maximedaniel/CairnFORM/img/case.png

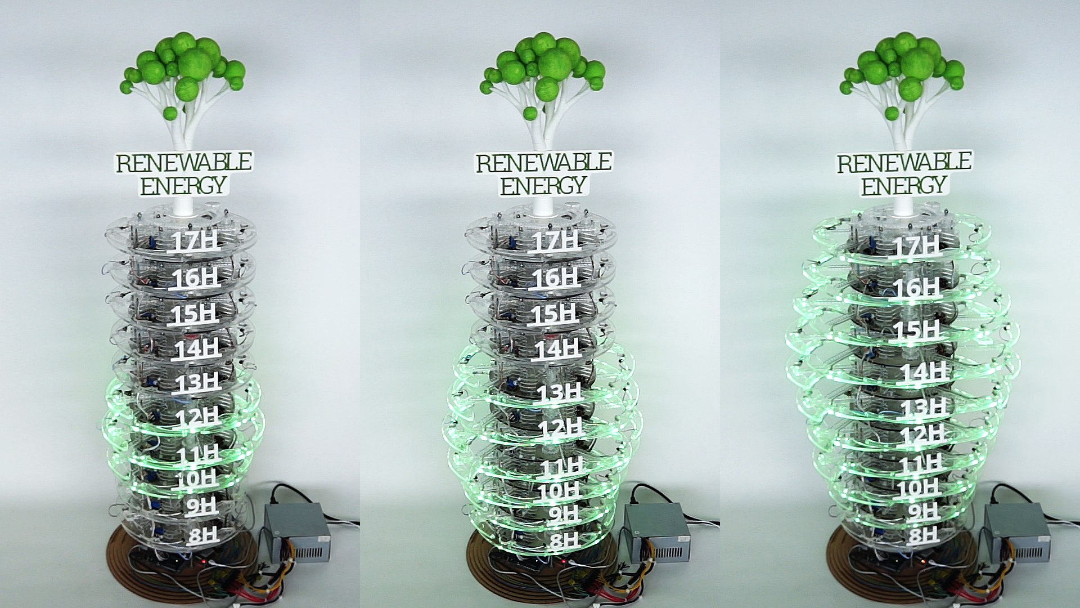
img/case.png
