maximedaniel/CairnFORM/img/tech0.png

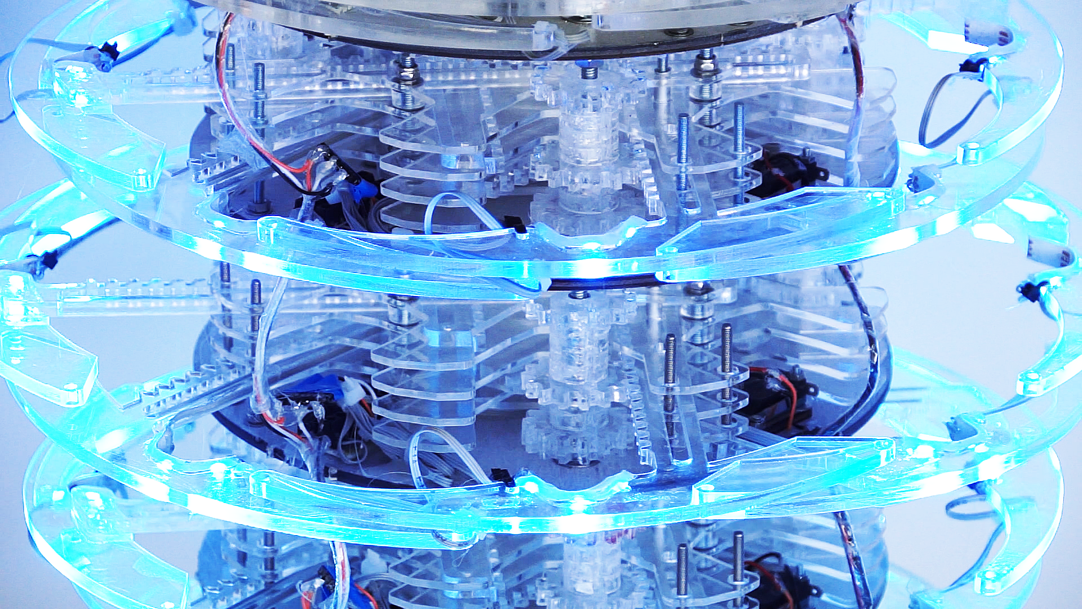
img/tech0.png
