maximedaniel/CairnFORM/img/tech1.png

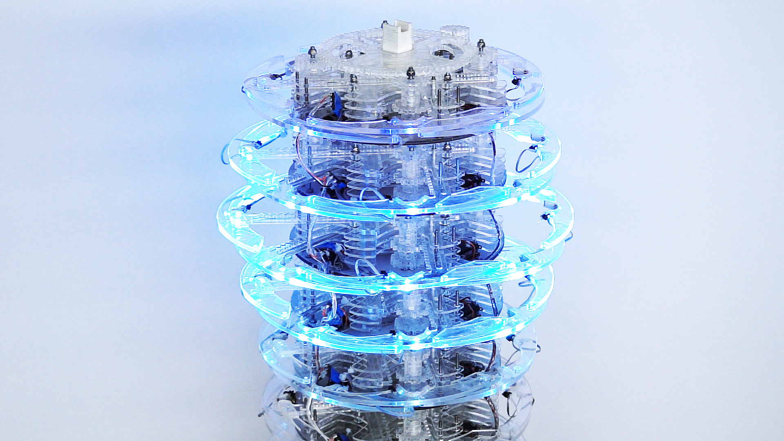
img/tech1.png
