maximedaniel/CairnFORM/img/tech2.png

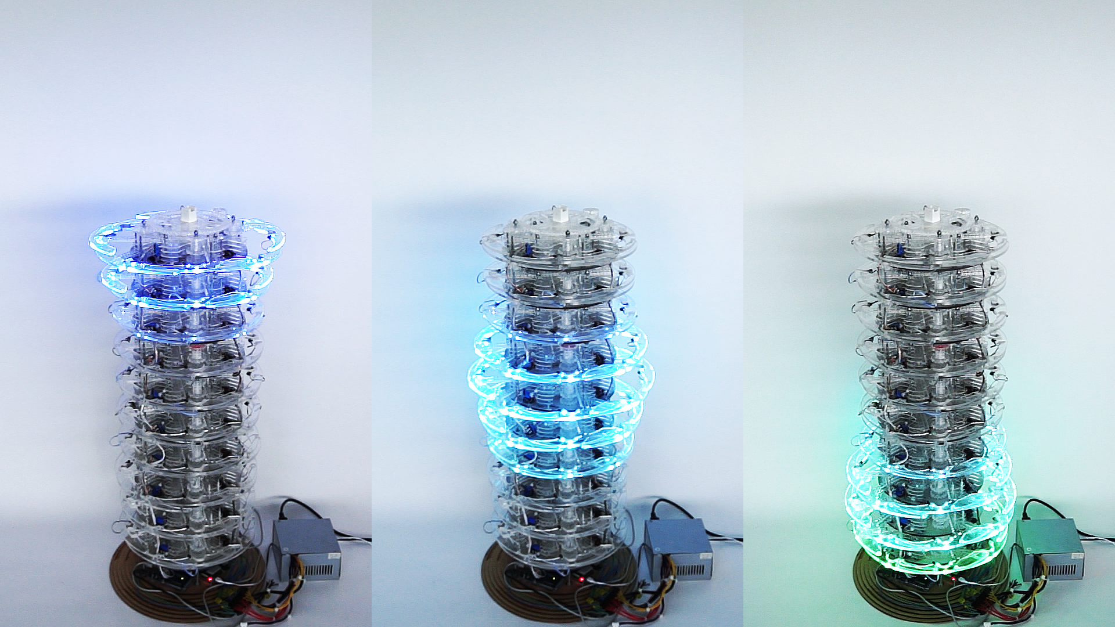
img/tech2.png
