maximedaniel/CairnFORM/driver/Arduino_Mega/Arduino_Mega.ino

#include <Adafruit_NeoPixel.h>
#include <stdio.h>
#include <stdlib.h>
#ifdef __AVR__
  #include <avr/power.h>
#endif

#define NUMPIXELS        12
#define PWM_SIZE         12
#define PWM_0            13
#define PWM_1            12
#define PWM_2            11
#define PWM_3            10
#define PWM_4            9
#define PWM_5            8
#define PWM_6            7
#define PWM_7            6
#define PWM_8            5
#define PWM_9            4
#define PWM_10           3
#define PWM_11           2


// Parameter 1 = number of pixels in strip
// Parameter 2 = Arduino pin number (most are valid)
// Parameter 3 = pixel type flags, add together as needed:
//   NEO_KHZ800  800 KHz bitstream (most NeoPixel products w/WS2812 LEDs)
//   NEO_KHZ400  400 KHz (classic 'v1' (not v2) FLORA pixels, WS2811 drivers)
//   NEO_GRB     Pixels are wired for GRB bitstream (most NeoPixel products)
//   NEO_RGB     Pixels are wired for RGB bitstream (v1 FLORA pixels, not v2)
//   NEO_RGBW    Pixels are wired for RGBW bitstream (NeoPixel RGBW products)

Adafruit_NeoPixel pixels [PWM_SIZE] = {
    Adafruit_NeoPixel(NUMPIXELS, PWM_0, NEO_GRB + NEO_KHZ800),
    Adafruit_NeoPixel(NUMPIXELS, PWM_1, NEO_GRB + NEO_KHZ800),
    Adafruit_NeoPixel(NUMPIXELS, PWM_2, NEO_GRB + NEO_KHZ800),
    Adafruit_NeoPixel(NUMPIXELS, PWM_3, NEO_GRB + NEO_KHZ800),
    Adafruit_NeoPixel(NUMPIXELS, PWM_4, NEO_GRB + NEO_KHZ800),
    Adafruit_NeoPixel(NUMPIXELS, PWM_5, NEO_GRB + NEO_KHZ800),
    Adafruit_NeoPixel(NUMPIXELS, PWM_6, NEO_GRB + NEO_KHZ800),
    Adafruit_NeoPixel(NUMPIXELS, PWM_7, NEO_GRB + NEO_KHZ800),
    Adafruit_NeoPixel(NUMPIXELS, PWM_8, NEO_GRB + NEO_KHZ800),
    Adafruit_NeoPixel(NUMPIXELS, PWM_9, NEO_GRB + NEO_KHZ800),
    Adafruit_NeoPixel(NUMPIXELS, PWM_10, NEO_GRB + NEO_KHZ800),
    Adafruit_NeoPixel(NUMPIXELS, PWM_11, NEO_GRB + NEO_KHZ800)
};

int SIZE_PACKAGE = 4;

// IMPORTANT: To reduce NeoPixel burnout risk, add 1000 uF capacitor across
// pixel power leads, add 300 - 500 Ohm resistor on first pixel's data input
// and minimize distance between Arduino and first pixel.  Avoid connecting
// on a live circuit...if you must, connect GND first.



int delayval = 500; // delay for half a second

void setup() {
  // This is for Trinket 5V 16MHz, you can remove these three lines if you are not using a Trinket
  Serial.begin(9600);
#if defined (__AVR_ATtiny85__)
  if (F_CPU == 16000000) clock_prescale_set(clock_div_1);
#endif
  // End of trinket special code

  for(int j=0;j<PWM_SIZE;j++){
      pixels[j].begin(); // This initializes the NeoPixel library.
  }
}

void loop() { 
  // Read serial input:
   char package[SIZE_PACKAGE];
  while (Serial.available() > SIZE_PACKAGE - 1) {
    Serial.readBytes(package, SIZE_PACKAGE);
    if(package[0] >= 0 && package[0]<PWM_SIZE){
      for(int i = 0; i < NUMPIXELS; i++){
        pixels[package[0]].setPixelColor(i, pixels[package[0]].Color(package[1], package[2], package[3]));
      }
      pixels[package[0]].show(); 
    }
  }
}
