maximedaniel/CairnFORM/driver/Transition.py

import math

# Define motion transition modes
class Transition:
    LINEAR = 'LINEAR'
    EASE_IN_QUAD = 'EASE_IN_QUAD'
    EASE_OUT_QUAD = 'EASE_OUT_QUAD'
    EASE_IN_OUT_QUAD = 'EASE_IN_OUT_QUAD'

    EASE_IN_CUBIC = 'EASE_IN_CUBIC'
    EASE_OUT_CUBIC = 'EASE_OUT_CUBIC'
    EASE_IN_OUT_CUBIC = 'EASE_IN_OUT_CUBIC'

    EASE_IN_QUART = 'EASE_IN_QUART'
    EASE_OUT_QUART = 'EASE_OUT_QUART'
    EASE_IN_OUT_QUART = 'EASE_IN_OUT_QUART'

    EASE_IN_QUINT = 'EASE_IN_QUINT'
    EASE_OUT_QUINT = 'EASE_OUT_QUINT'
    EASE_IN_OUT_QUINT = 'EASE_IN_OUT_QUINT'

    EASE_IN_SINE = 'EASE_IN_SINE'
    EASE_OUT_SINE = 'EASE_OUT_SINE'
    EASE_IN_OUT_SINE = 'EASE_IN_OUT_SINE'

    EASE_IN_EXPO = 'EASE_IN_EXPO'
    EASE_OUT_EXPO = 'EASE_OUT_EXPO'
    EASE_IN_OUT_EXPO = 'EASE_IN_OUT_EXPO'

    EASE_IN_CIRC = 'EASE_IN_CIRC'
    EASE_OUT_CIRC = 'EASE_OUT_CIRC'
    EASE_IN_OUT_CIRC = 'EASE_IN_OUT_CIRC'

    # simple linear tweening - no easing, no acceleration
    @classmethod
    def linearTween(cls, t, b, c, d):
        return c * t / d + b

    # quadratic easing in - accelerating from zero velocity

    @classmethod
    def easeInQuad(cls, t, b, c, d):
        t /= d
        return c * t * t + b

    # quadratic easing out - decelerating to zero velocity

    @classmethod
    def easeOutQuad(cls, t, b, c, d):
        t /= d
        return -c * t * (t - 2) + b

    # quadratic easing in/out - acceleration until halfway, then deceleration

    @classmethod
    def easeInOutQuad(cls, t, b, c, d):
        t /= d / 2
        if t < 1:
            return c / 2 * t * t + b
        t -= 1
        return -c / 2 * (t * (t - 2) - 1) + b

    # cubic easing in - accelerating from zero velocity

    @classmethod
    def easeInCubic(cls, t, b, c, d):
        t /= d
        return c * t * t * t + b

    # cubic easing out - decelerating to zero velocity

    @classmethod
    def easeOutCubic(cls, t, b, c, d):
        t /= d
        t -= 1
        return c * (t * t * t + 1) + b

    # cubic easing in/out - acceleration until halfway, then deceleration

    @classmethod
    def easeInOutCubic(cls, t, b, c, d):
        t /= d / 2
        if t < 1:
            return c / 2 * t * t * t + b
        t -= 2
        return c / 2 * (t * t * t + 2) + b

    # quartic easing in - accelerating from zero velocity

    @classmethod
    def easeInQuart(cls, t, b, c, d):
        t /= d
        return c * t * t * t * t + b

    # quartic easing out - decelerating to zero velocity

    @classmethod
    def easeOutQuart(cls, t, b, c, d):
        t /= d
        t -= 1
        return -c * (t * t * t * t - 1) + b

    # quartic easing in/out - acceleration until halfway, then deceleration

    @classmethod
    def easeInOutQuart(cls, t, b, c, d):
        t /= d / 2
        if t < 1:
            return c / 2 * t * t * t * t + b
        t -= 2
        return -c / 2 * (t * t * t * t - 2) + b

    # quintic easing in - accelerating from zero velocity

    @classmethod
    def easeInQuint(cls, t, b, c, d):
        t /= d
        return c * t * t * t * t * t + b

    # quintic easing out - decelerating to zero velocity

    @classmethod
    def easeOutQuint(cls, t, b, c, d):
        t /= d
        t -= 1
        return c * (t * t * t * t * t + 1) + b

    # quintic easing in/out - acceleration until halfway, then deceleration

    @classmethod
    def easeInOutQuint(cls, t, b, c, d):
        t /= d / 2
        if t < 1:
            return c / 2 * t * t * t * t * t + b
        t -= 2
        return c / 2 * (t * t * t * t * t + 2) + b

    # sinusoidal easing in - accelerating from zero velocity

    @classmethod
    def easeInSine(cls, t, b, c, d):
        return -c * math.cos(t / d * (math.pi / 2)) + c + b

    # sinusoidal easing out - decelerating to zero velocity

    @classmethod
    def easeOutSine(cls, t, b, c, d):
        return c * math.sin(t / d * (math.pi / 2)) + b

    # sinusoidal easing in/out - accelerating until halfway, then decelerating

    @classmethod
    def easeInOutSine(cls, t, b, c, d):
        return -c / 2 * (math.cos(math.pi * t / d) - 1) + b

    # exponential easing in - accelerating from zero velocity

    @classmethod
    def easeInExpo(cls, t, b, c, d):
        return c * math.pow(2, 10 * (t / d - 1)) + b

    # exponential easing out - decelerating to zero velocity

    @classmethod
    def easeOutExpo(cls, t, b, c, d):
        return c * (-math.pow(2, -10 * t / d) + 1) + b

    # exponential easing in/out - accelerating until halfway, then decelerating

    @classmethod
    def easeInOutExpo(cls, t, b, c, d):
        t /= d / 2
        if t < 1:
            return c / 2 * math.pow(2, 10 * (t - 1)) + b
        t -= 1
        return c / 2 * (-math.pow(2, -10 * t) + 2) + b

    # circular easing in - accelerating from zero velocity

    @classmethod
    def easeInCirc(cls, t, b, c, d):
        t /= d
        return -c * (math.sqrt(1 - t * t) - 1) + b

    # circular easing out - decelerating to zero velocity

    @classmethod
    def easeOutCirc(cls, t, b, c, d):
        t /= d
        t -= 1
        return c * math.sqrt(1 - t * t) + b

    # circular easing in/out - acceleration until halfway, then deceleration

    @classmethod
    def easeInOutCirc(cls, t, b, c, d):
        t /= d / 2
        if t < 1:
            return -c / 2 * (math.sqrt(1 - t * t) - 1) + b
        t -= 2
        return c / 2 * (math.sqrt(1 - t * t) + 1) + b

    @classmethod
    def transition(cls, mode, t, b, c, d):
        if mode == cls.LINEAR:
            return cls.linearTween(t, b, c, d)

        if mode == cls.EASE_IN_QUAD:
            return cls.easeInQuad(t, b, c, d)

        if mode == cls.EASE_OUT_QUAD:
            return cls.easeOutQuad(t, b, c, d)

        if mode == cls.EASE_IN_OUT_QUAD:
            return cls.easeInOutQuad(t, b, c, d)

        if mode == cls.EASE_IN_CUBIC:
            return cls.easeInCubic(t, b, c, d)

        if mode == cls.EASE_OUT_CUBIC:
            return cls.easeOutCubic(t, b, c, d)

        if mode == cls.EASE_IN_OUT_CUBIC:
            return cls.easeInOutCubic(t, b, c, d)

        if mode == cls.EASE_IN_QUART:
            return cls.easeInQuart(t, b, c, d)

        if mode == cls.EASE_OUT_QUART:
            return cls.easeOutQuart(t, b, c, d)

        if mode == cls.EASE_IN_OUT_QUART:
            return cls.easeInOutQuart(t, b, c, d)

        if mode == cls.EASE_IN_QUINT:
            return cls.easeInQuint(t, b, c, d)

        if mode == cls.EASE_OUT_QUINT:
            return cls.easeOutQuint(t, b, c, d)

        if mode == cls.EASE_IN_OUT_QUINT:
            return cls.easeInOutQuint(t, b, c, d)

        if mode == cls.EASE_IN_SINE:
            return cls.easeInSine(t, b, c, d)

        if mode == cls.EASE_OUT_SINE:
            return cls.easeOutSine(t, b, c, d)

        if mode == cls.EASE_IN_OUT_SINE:
            return cls.easeInOutSine(t, b, c, d)

        if mode == cls.EASE_IN_EXPO:
            return cls.easeInExpo(t, b, c, d)

        if mode == cls.EASE_OUT_EXPO:
            return cls.easeOutExpo(t, b, c, d)

        if mode == cls.EASE_IN_OUT_EXPO:
            return cls.easeInOutExpo(t, b, c, d)

        if mode == cls.EASE_IN_CIRC:
            return cls.easeInCirc(t, b, c, d)

        if mode == cls.EASE_OUT_CIRC:
            return cls.easeOutCirc(t, b, c, d)

        if mode == cls.EASE_IN_OUT_CIRC:
            return cls.easeInOutCirc(t, b, c, d)

    @classmethod
    def isMode(cls, mode):
        if mode == cls.LINEAR:
            return True

        if mode == cls.EASE_IN_QUAD:
            return True

        if mode == cls.EASE_OUT_QUAD:
            return True

        if mode == cls.EASE_IN_OUT_QUAD:
            return True

        if mode == cls.EASE_IN_CUBIC:
            return True

        if mode == cls.EASE_OUT_CUBIC:
            return True

        if mode == cls.EASE_IN_OUT_CUBIC:
            return True

        if mode == cls.EASE_IN_QUART:
            return True

        if mode == cls.EASE_OUT_QUART:
            return True

        if mode == cls.EASE_IN_OUT_QUART:
            return True

        if mode == cls.EASE_IN_QUINT:
            return True

        if mode == cls.EASE_OUT_QUINT:
            return True

        if mode == cls.EASE_IN_OUT_QUINT:
            return True

        if mode == cls.EASE_IN_SINE:
            return True

        if mode == cls.EASE_OUT_SINE:
            return True

        if mode == cls.EASE_IN_OUT_SINE:
            return True

        if mode == cls.EASE_IN_EXPO:
            return True

        if mode == cls.EASE_OUT_EXPO:
            return True

        if mode == cls.EASE_IN_OUT_EXPO:
            return True

        if mode == cls.EASE_IN_CIRC:
            return True

        if mode == cls.EASE_OUT_CIRC:
            return True

        if mode == cls.EASE_IN_OUT_CIRC:
            return True

        return False
