maximedaniel/CairnFORM/(commit log)

2019-03-01 Updating Arduino Mega Driver
2019-03-13 debugging : problem with transition function and negative parameters
    [CairnFORM.py, RingController.py]
2021-01-07 Adding test files for LEDs and contact switches
2021-01-07 Adding instructions for remote programmng using a WiFi AP Raspberry Pi
